CUERT-Shell/OpenPowerModuleBrainDead_V0SL/PowerModule/PowerModule.kicad_pcb

## KiCad design PowerModule/PowerModule.kicad_pcb (2025-09-24)

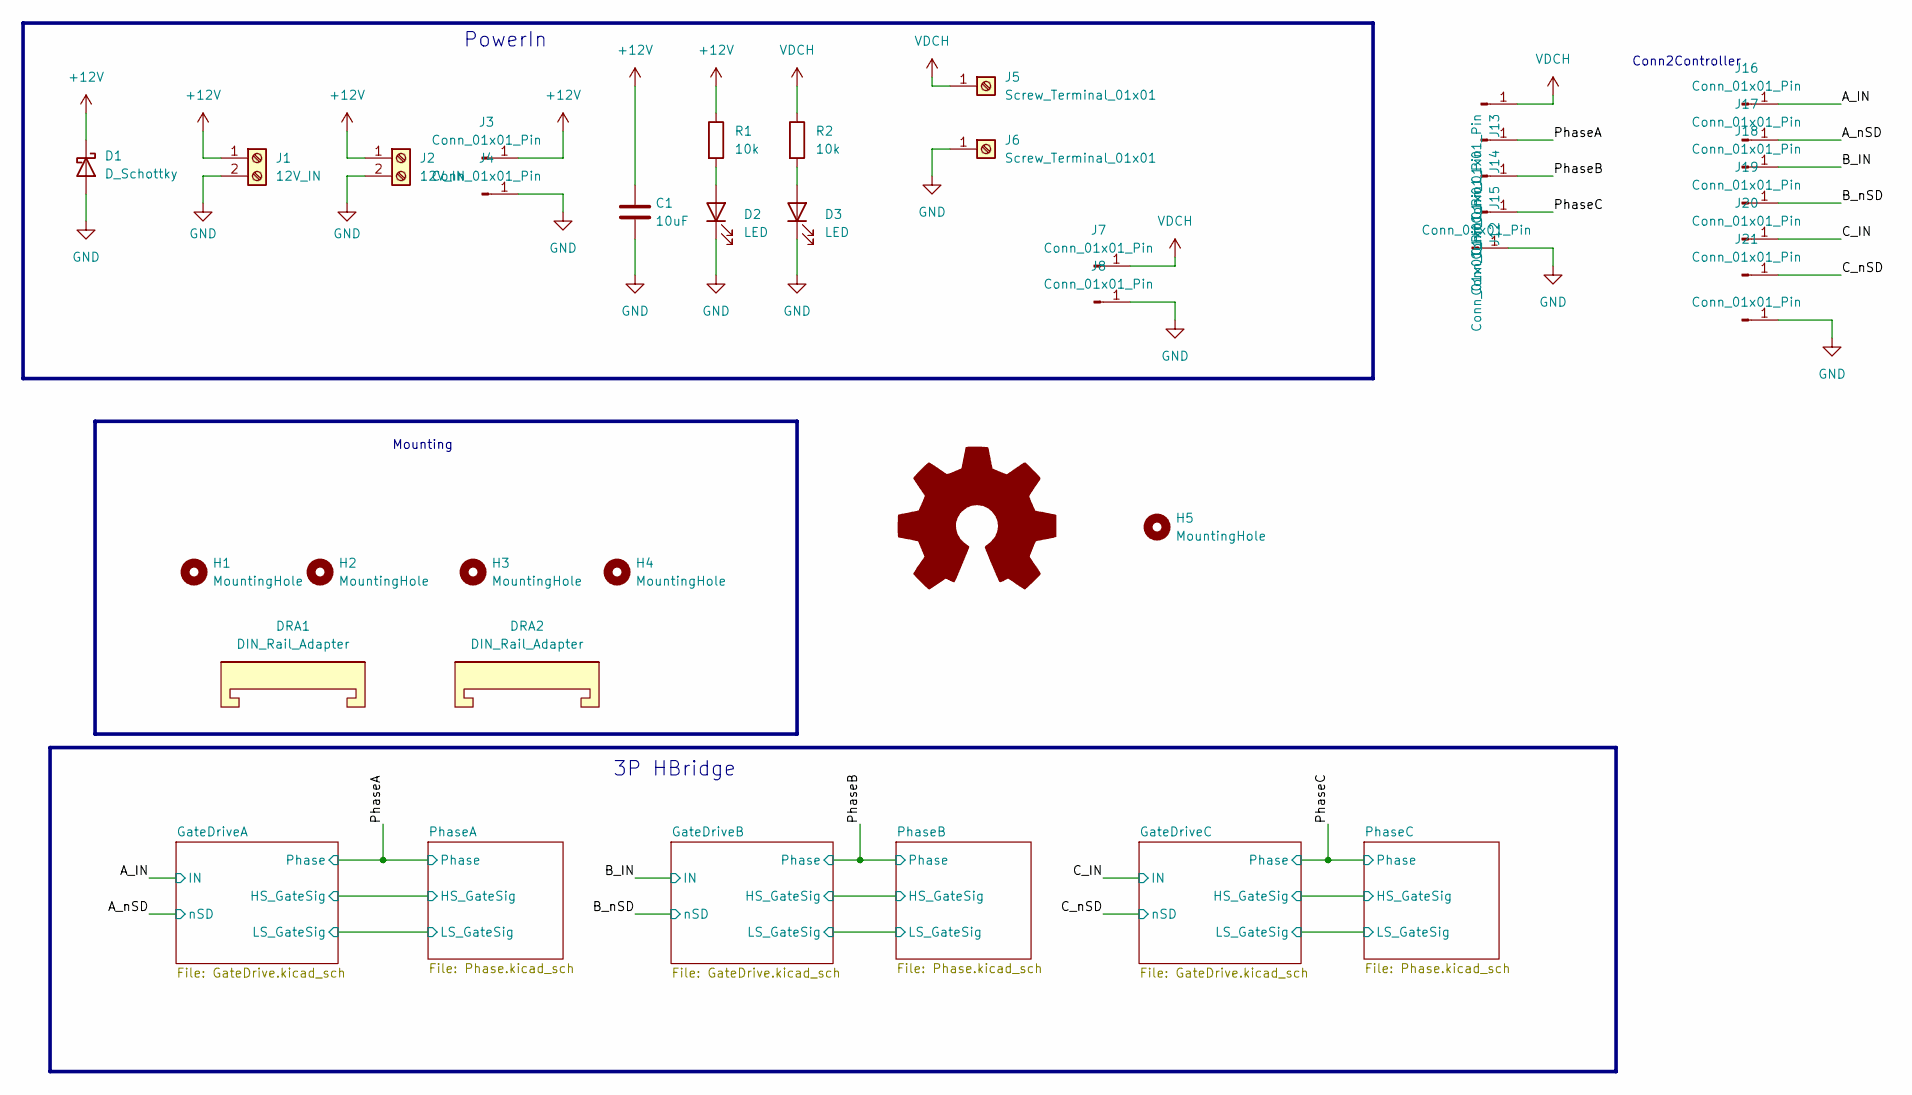
[picture p5: schematic PowerModule.kicad_sch]

Parts:
C1: 10uF; C_1206_3216Metric
D1: D_Schottky; D_SMC-RM10_Universal_Handsoldering
D2, D3: LED; LED_1206_3216Metric_Pad1.42x1.75mm_HandSolder
DRA1, DRA2: DIN_Rail_Adapter; DinRailPCBClip_P15
H1, H2, H3, H4: MountingHole; MountingHole_3.2mm_M3_DIN965
H5: MountingHole; KiCad-Logo2_12mm_SilkScreen
J1, J2: 12V_IN; TerminalBlock_Phoenix_PT-1,5-2-3.5-H_1x02_P3.50mm_Horizontal
J3, J4, J7, J8, J11, J12, J13, J14, J15, J16, J17, J18, J19, J20, J21, J22: Conn_01x01_Pin; WirePad_2.5x5
J5, J6: Screw_Terminal_01x01; D5mm_WirePad
R1, R2: 10k; R_1206_3216Metric_Pad1.30x1.75mm_HandSolder

Connections:
+12V: C1.1, D1.1 (K), J1.1, J2.1, J3.1, R1.1; also elsewhere on the board
/A_IN: J16.1; also elsewhere on the board
/A_nSD: J17.1; also elsewhere on the board
/B_IN: J18.1; also elsewhere on the board
/B_nSD: J19.1; also elsewhere on the board
/C_IN: J20.1; also elsewhere on the board
/C_nSD: J21.1; also elsewhere on the board
/PhaseA: J14.1; also elsewhere on the board
/PhaseB: J15.1; also elsewhere on the board
/PhaseC: J12.1; also elsewhere on the board
GND: C1.2, D1.2 (A), D2.1 (K), D3.1 (K), J1.2, J2.2, J4.1, J6.1, J8.1, J11.1, J22.1; also elsewhere on the board
unnamed: D2.2 (A), R1.2
unnamed: D3.2 (A), R2.2
VDCH: J5.1, J7.1, J13.1, R2.1; also elsewhere on the board

Notes on the sheet:
Mounting
3P HBridge
Conn2Controller
PowerIn

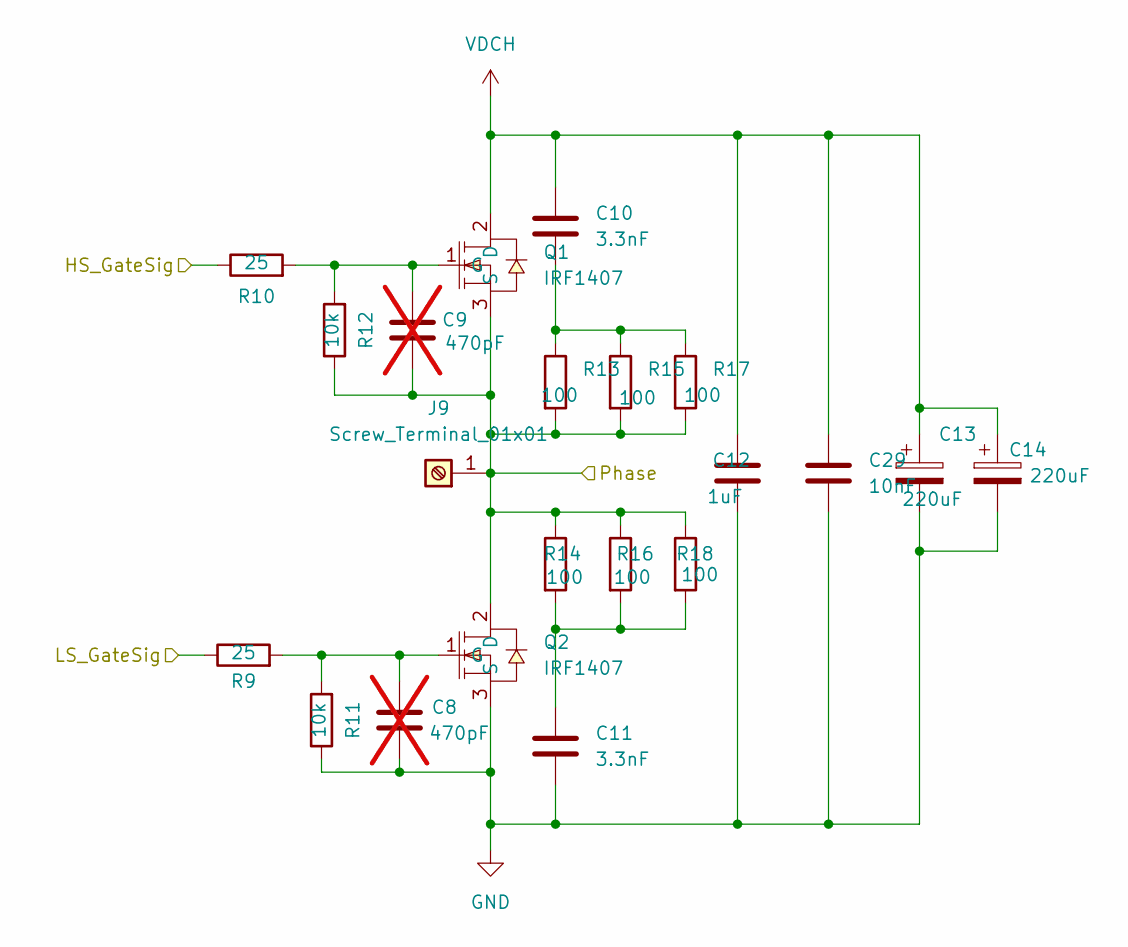
[picture p6: schematic Phase.kicad_sch]

Parts:
C8, C9: 470pF; C_1206_3216Metric; not fitted
C10, C11: 3.3nF; C_Rect_L7.2mm_W3.5mm_P5.00mm_FKS2_FKP2_MKS2_MKP2
C12: 1uF; C_Rect_L9.0mm_W5.1mm_P7.50mm_MKT
C13: 220uF; CP_Radial_Horizontal_P5.00_Up
C14: 220uF; CP_Radial_Horizontal_P5.00_Down
C29: 10nF; C_Rect_L7.2mm_W3.5mm_P5.00mm_FKS2_FKP2_MKS2_MKP2
J9: Screw_Terminal_01x01; D5mm_WirePad
Q1, Q2: IRF1407; TO-220-3_Horizontal_TabUp; LCSC Part C33129604
R9, R10: 25; R_1206_3216Metric
R11, R12: 10k; R_1206_3216Metric
R13, R14, R15, R16, R17, R18: 100; R_1206_3216Metric

Connections:
/GateDriveA/HS_GateSig: R10.1; also elsewhere on the board
/GateDriveA/LS_GateSig: R9.1; also elsewhere on the board
/PhaseA: C9.2, J9.1, Q1.3 (S), Q2.2 (D), R12.1, R13.2, R14.1, R15.2, R16.1, R17.2, R18.1; also elsewhere on the board
GND: C8.2, C11.2, C12.2, C13.2, C14.2, C29.2, Q2.3 (S), R11.1; also elsewhere on the board
unnamed: C10.2, R13.1, R15.1, R17.1
unnamed: C11.1, R14.2, R16.2, R18.2
unnamed: C9.1, Q1.1 (G), R10.2, R12.2
unnamed: C8.1, Q2.1 (G), R9.2, R11.2
VDCH: C10.1, C12.1, C13.1, C14.1, C29.1, Q1.2 (D); also elsewhere on the board

Parts of its further copies:
C15, C16, C22, C23: 470pF; C_1206_3216Metric; not fitted
C17, C18, C24, C25: 3.3nF; C_Rect_L7.2mm_W3.5mm_P5.00mm_FKS2_FKP2_MKS2_MKP2
C19, C26: 1uF; C_Rect_L9.0mm_W5.1mm_P7.50mm_MKT
C20, C27: 220uF; CP_Radial_Horizontal_P5.00_Up
C21, C28: 220uF; CP_Radial_Horizontal_P5.00_Down
C30, C31: 10nF; C_Rect_L7.2mm_W3.5mm_P5.00mm_FKS2_FKP2_MKS2_MKP2
J10, J23: Screw_Terminal_01x01; D5mm_WirePad
Q3, Q4, Q5, Q6: IRF1407; TO-220-3_Horizontal_TabUp; LCSC Part C33129604
R19, R20, R29, R30: 25; R_1206_3216Metric
R21, R22, R31, R32: 10k; R_1206_3216Metric
R23, R24, R25, R26, R27, R28, R33, R34, R35, R36, R37, R38: 100; R_1206_3216Metric

Connections of its further copies:
/GateDriveB/HS_GateSig: R20.1; also elsewhere on the board
/GateDriveB/LS_GateSig: R19.1; also elsewhere on the board
/GateDriveC/HS_GateSig: R30.1; also elsewhere on the board
/GateDriveC/LS_GateSig: R29.1; also elsewhere on the board
/PhaseB: C16.2, J10.1, Q3.3 (S), Q4.2 (D), R22.1, R23.2, R24.1, R25.2, R26.1, R27.2, R28.1; also elsewhere on the board
/PhaseC: C23.2, J23.1, Q5.3 (S), Q6.2 (D), R32.1, R33.2, R34.1, R35.2, R36.1, R37.2, R38.1; also elsewhere on the board
GND: C15.2, C18.2, C19.2, C20.2, C21.2, C22.2, C25.2, C26.2, C27.2, C28.2, C30.2, C31.2, Q4.3 (S), Q6.3 (S), R21.1, R31.1; also elsewhere on the board
unnamed: C17.2, R23.1, R25.1, R27.1
unnamed: C18.1, R24.2, R26.2, R28.2
unnamed: C24.2, R33.1, R35.1, R37.1
unnamed: C25.1, R34.2, R36.2, R38.2
unnamed: C16.1, Q3.1 (G), R20.2, R22.2
unnamed: C15.1, Q4.1 (G), R19.2, R21.2
unnamed: C23.1, Q5.1 (G), R30.2, R32.2
unnamed: C22.1, Q6.1 (G), R29.2, R31.2
VDCH: C17.1, C19.1, C20.1, C21.1, C24.1, C26.1, C27.1, C28.1, C30.1, C31.1, Q3.2 (D), Q5.2 (D); also elsewhere on the board

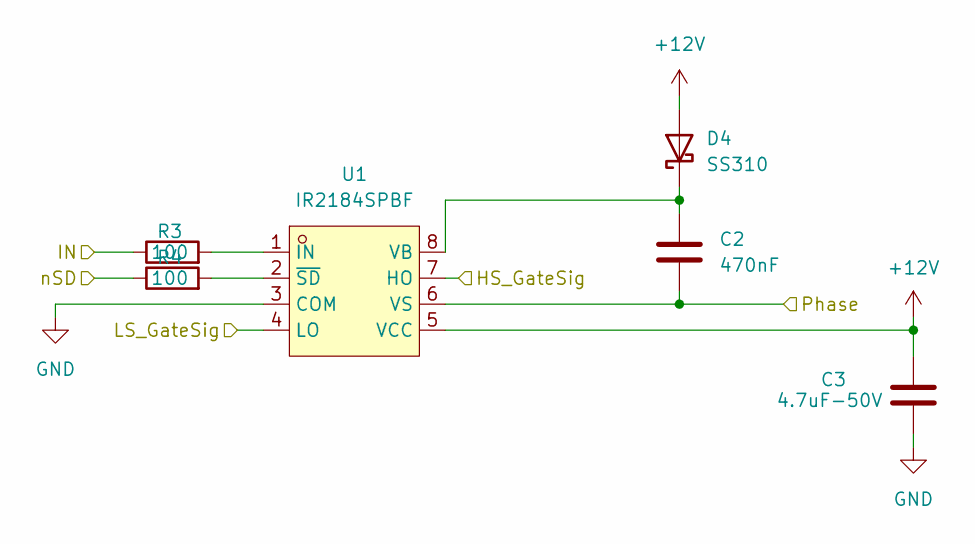
[picture p7: schematic GateDrive.kicad_sch]

Parts:
C2: 470nF; C_Rect_L9.0mm_W5.1mm_P7.50mm_MKT
C3: 4.7uF-50V; C_1206_3216Metric
D4: SS310; D_SMC-RM10_Universal_Handsoldering
R3, R4: 100; R_1206_3216Metric
U1: IR2184SPBF; SOIC-8_L5.0-W4.0-P1.27-LS6.0-BL; LCSC Part C537610

Connections:
+12V: C3.1, D4.2 (A), U1.5 (VCC); also elsewhere on the board
/A_IN: R3.1; also elsewhere on the board
/A_nSD: R4.1; also elsewhere on the board
/GateDriveA/HS_GateSig: U1.7 (HO); also elsewhere on the board
/GateDriveA/LS_GateSig: U1.4 (LO); also elsewhere on the board
/PhaseA: C2.2, U1.6 (VS); also elsewhere on the board
GND: C3.2, U1.3 (COM); also elsewhere on the board
unnamed: C2.1, D4.1 (K), U1.8 (VB)
unnamed: R3.2, U1.1 (IN)
unnamed: R4.2, U1.2 (~SD)

Parts of its further copies:
C4, C6: 470nF; C_Rect_L9.0mm_W5.1mm_P7.50mm_MKT
C5, C7: 4.7uF-50V; C_1206_3216Metric
D5, D6: SS310; D_SMC-RM10_Universal_Handsoldering
R5, R6, R7, R8: 100; R_1206_3216Metric
U2, U3: IR2184SPBF; SOIC-8_L5.0-W4.0-P1.27-LS6.0-BL; LCSC Part C537610

Connections of its further copies:
+12V: C5.1, C7.1, D5.2 (A), D6.2 (A), U2.5 (VCC), U3.5 (VCC); also elsewhere on the board
/B_IN: R5.1; also elsewhere on the board
/B_nSD: R6.1; also elsewhere on the board
/C_IN: R7.1; also elsewhere on the board
/C_nSD: R8.1; also elsewhere on the board
/GateDriveB/HS_GateSig: U2.7 (HO); also elsewhere on the board
/GateDriveB/LS_GateSig: U2.4 (LO); also elsewhere on the board
/GateDriveC/HS_GateSig: U3.7 (HO); also elsewhere on the board
/GateDriveC/LS_GateSig: U3.4 (LO); also elsewhere on the board
/PhaseB: C4.2, U2.6 (VS); also elsewhere on the board
/PhaseC: C6.2, U3.6 (VS); also elsewhere on the board
GND: C5.2, C7.2, U2.3 (COM), U3.3 (COM); also elsewhere on the board
unnamed: C4.1, D5.1 (K), U2.8 (VB)
unnamed: C6.1, D6.1 (K), U3.8 (VB)
unnamed: R5.2, U2.1 (IN)
unnamed: R6.2, U2.2 (~SD)
unnamed: R7.2, U3.1 (IN)
unnamed: R8.2, U3.2 (~SD)

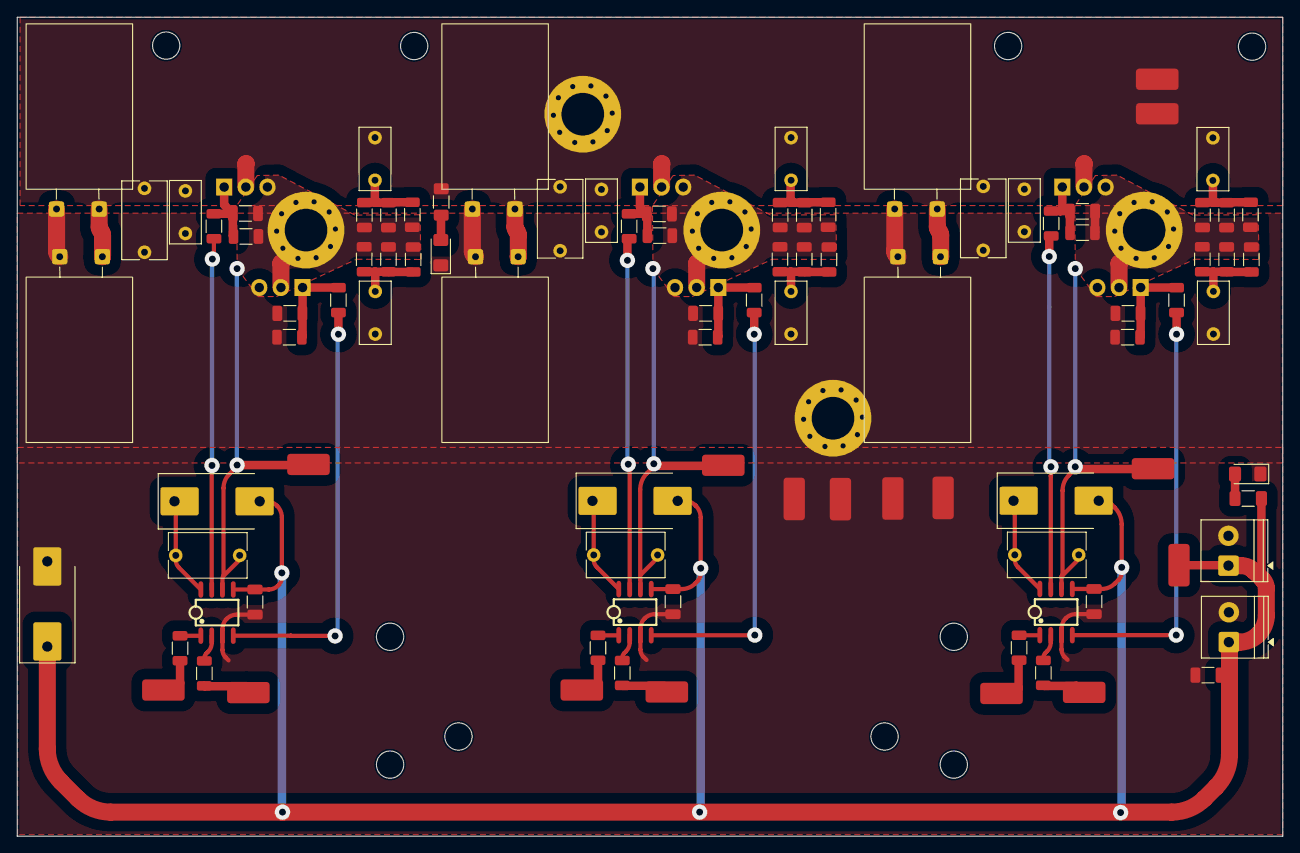
[picture p8: board PowerModule.kicad_pcb from above]

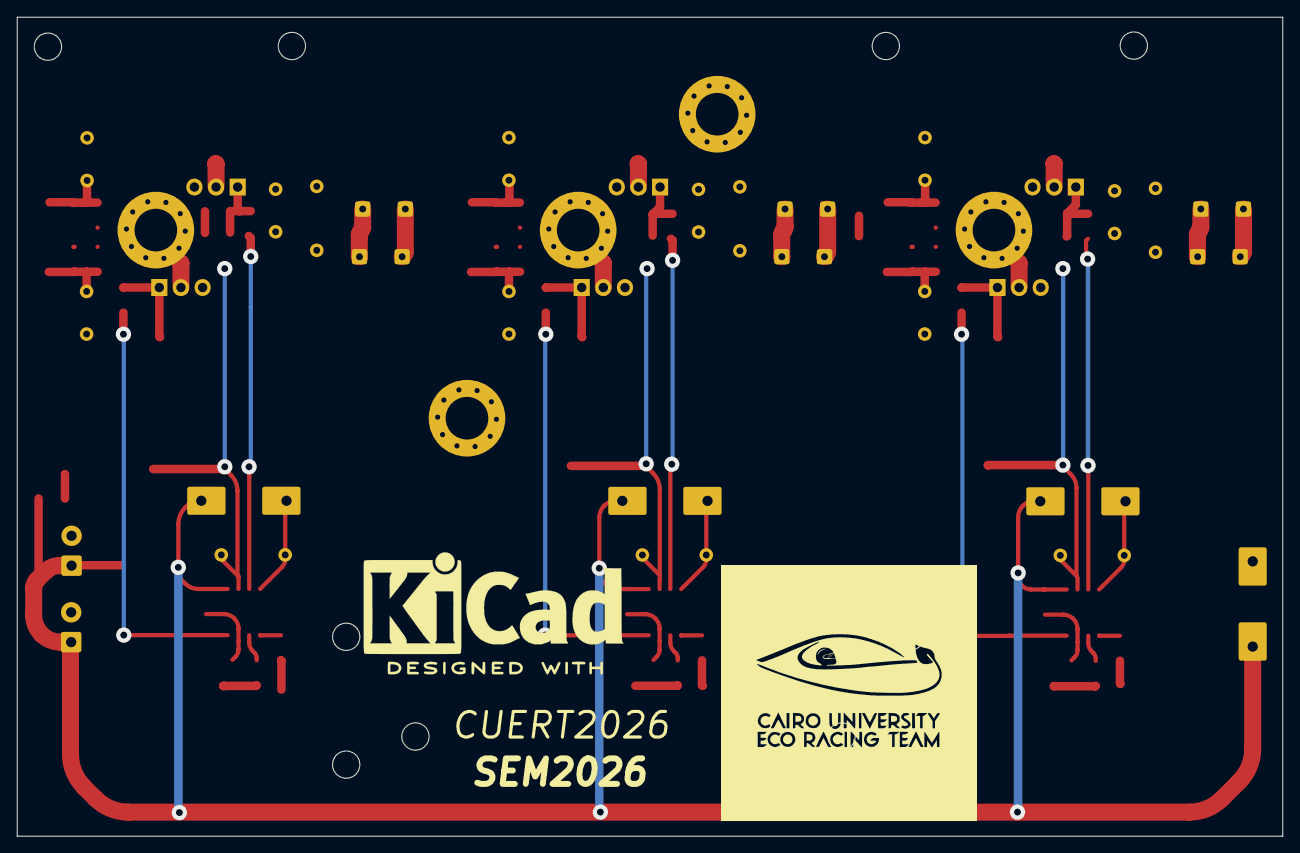
[picture p9: board PowerModule.kicad_pcb from below]

Board: 2 copper layers, 148.5 x 96.1 mm, 114 parts (7 on the bottom side), 41 nets.
