CUERT-Shell/OpenPowerModuleBrainDead_V0SL/PowerModuleInterface/PowerModuleInterface.kicad_pcb

## KiCad design PowerModuleInterface/PowerModuleInterface.kicad_pcb (2025-09-24)

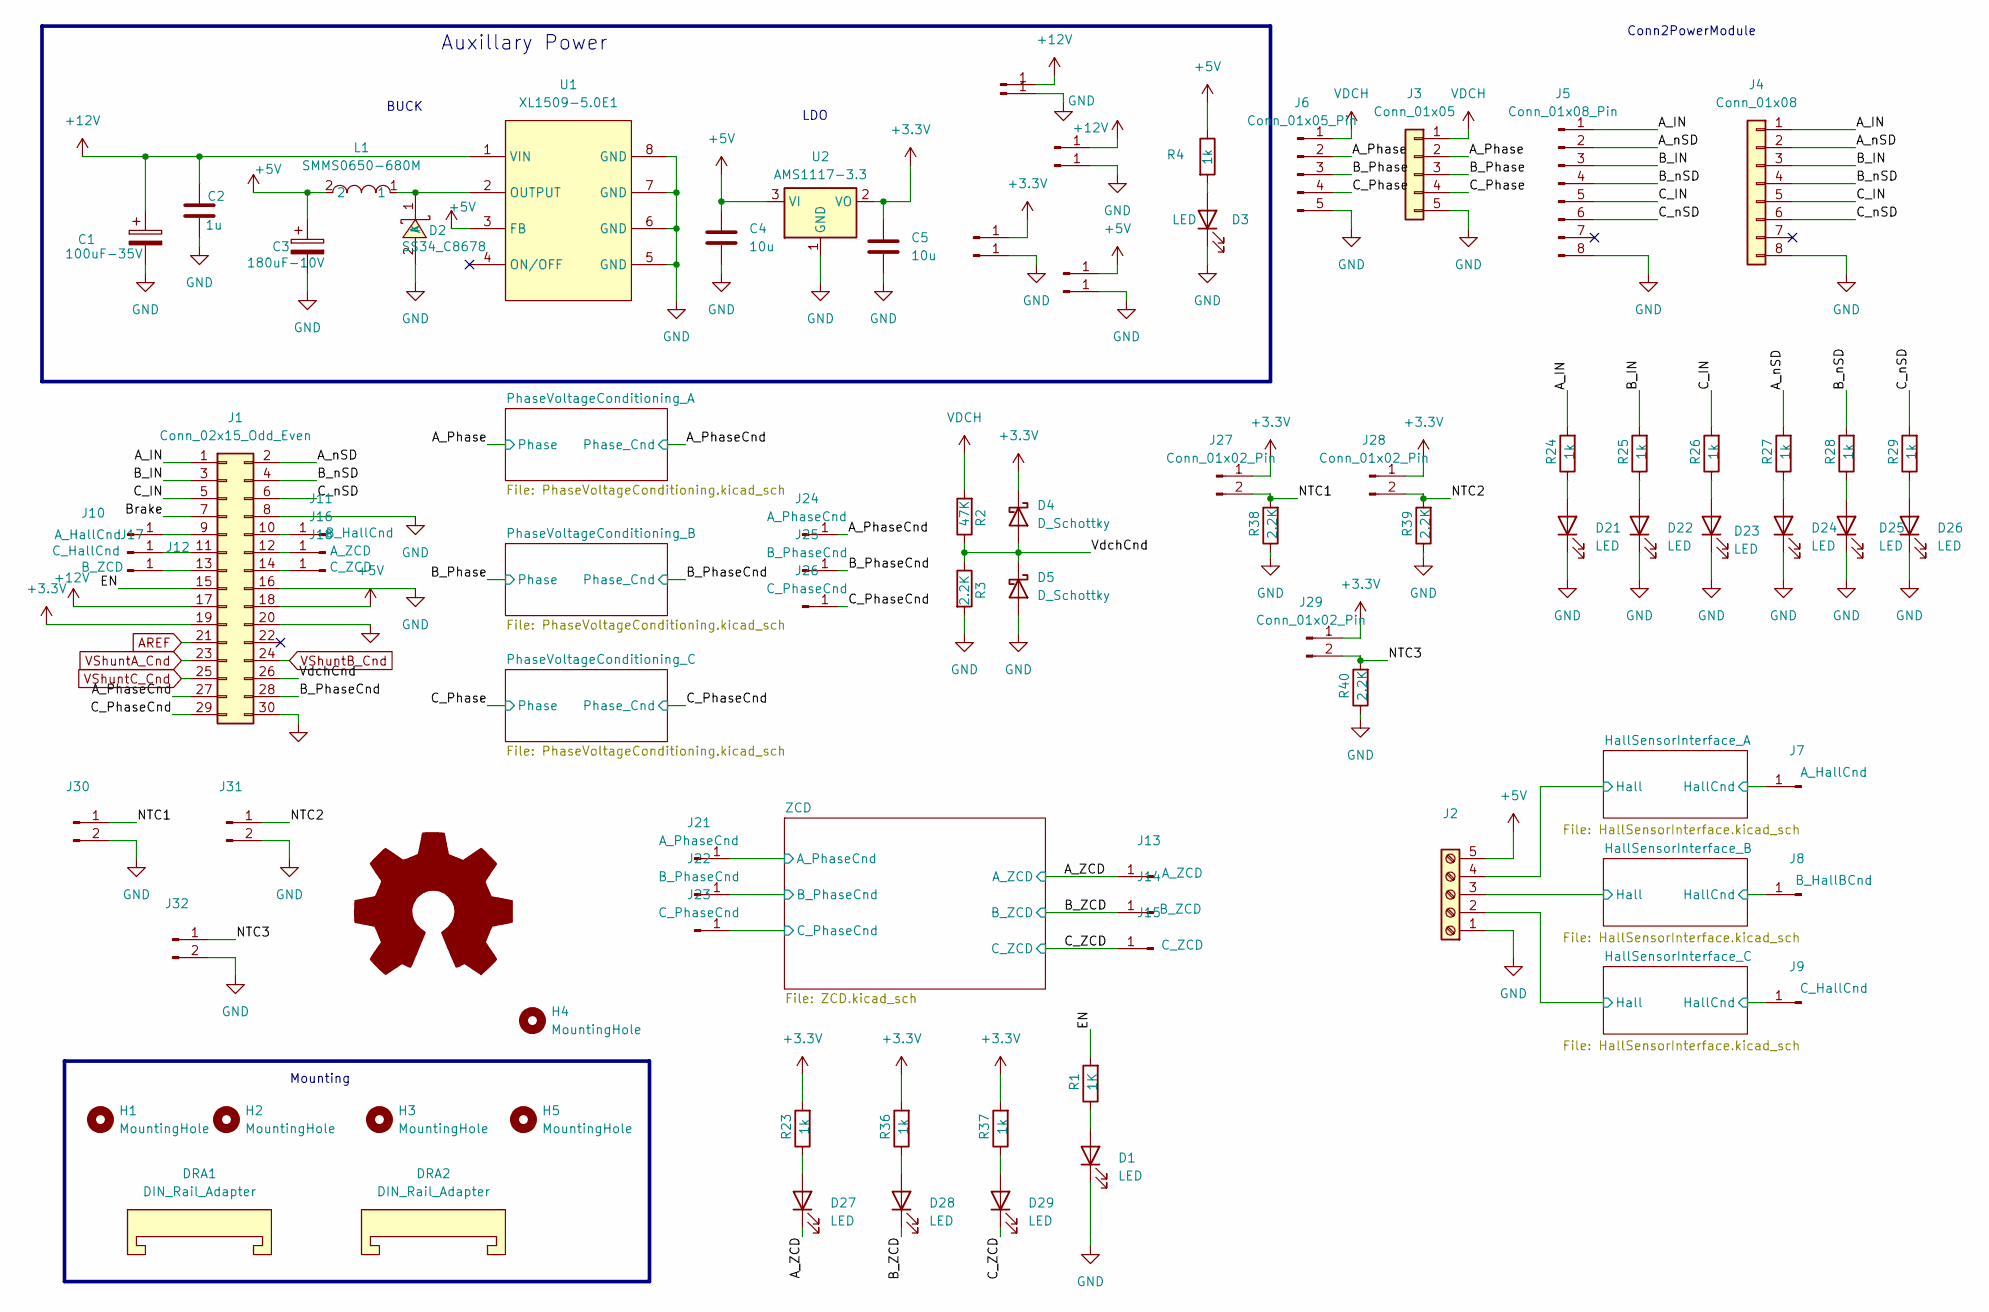
[picture p10: schematic PowerModuleInterface.kicad_sch]

Parts:
C1: 100uF-35V; CP_Radial_D6.3mm_P2.50mm
C2: 1u; C_1206_3216Metric
C3: 180uF-10V; CP_Radial_D6.3mm_P2.50mm
C4, C5: 10u; C_1206_3216Metric
D1, D3, D21, D22, D23, D24, D25, D26, D27, D28, D29: LED; LED_D3.0mm
D2: SS34_C8678; SMA_L4.3-W2.6-LS5.2-RD; LCSC Part C8678
D4, D5: D_Schottky; D_SOD-123; LCSC Part C181204
DRA1, DRA2: DIN_Rail_Adapter; DinRailPCBClip_P15
H1, H2, H3, H5: MountingHole; MountingHole_3.2mm_M3_DIN965
H4: MountingHole; KiCad-Logo2_6mm_SilkScreen
J1: Conn_02x15_Odd_Even; IDC-Header_2x15_P2.54mm_Vertical
J2: Screw_Terminal_01x05; TerminalBlock_Phoenix_PT-1,5-5-3.5-H_1x05_P3.50mm_Horizontal
J3: Conn_01x05; JST_XH_B5B-XH-A_1x05_P2.50mm_Vertical
J4: Conn_01x08; JST_XH_B8B-XH-A_1x08_P2.50mm_Vertical
J5: Conn_01x08_Pin; PinHeader_1x08_P2.54mm_Vertical
J6: Conn_01x05_Pin; PinHeader_1x05_P2.54mm_Vertical
J7, J10: A_HallCnd; WirePad_2.5x5
J8: B_HallBCnd; WirePad_2.5x5
J9, J12: C_HallCnd; WirePad_2.5x5
J11: B_HallCnd; WirePad_2.5x5
J13, J16: A_ZCD; WirePad_2.5x5
J14, J17: B_ZCD; WirePad_2.5x5
J15, J18: C_ZCD; WirePad_2.5x5
J19, J20, J33, J34, J35, J36, J37, J38: Conn_01x01_Pin; WirePad_2.5x5
J21, J24: A_PhaseCnd; WirePad_2.5x5
J22, J25: B_PhaseCnd; WirePad_2.5x5
J23, J26: C_PhaseCnd; WirePad_2.5x5
J27, J28, J29, J30, J31, J32: Conn_01x02_Pin; PinHeader_1x02_P2.54mm_Vertical
L1: SMMS0650-680M; IND-SMD_L7.1-W6.6_H5.0; LCSC Part C2894721
R1: 1K; R_1206_3216Metric; LCSC Part C113307
R2: 47K; R_1206_3216Metric
R3: 2.2K; R_1206_3216Metric
R4: 1k; R_1206_3216Metric
R23, R24, R25, R26, R27, R28, R29, R36, R37: 1k; R_1206_3216Metric; LCSC Part C113307
R38, R39, R40: 2.2K; R_1206_3216Metric; LCSC Part C113307
U1: XL1509-5.0E1; SOIC-8_L5.0-W4.0-P1.27-LS6.0-BL; LCSC Part C61063
U2: AMS1117-3.3; SOT-223-3_TabPin2

Connections:
+3.3V: C5.1, D4.1 (K), J1.19, J27.1, J28.1, J29.1, J37.1, R23.2, R36.2, R37.2, U2.2 (VO); also elsewhere on the board
+5V: C3.1, C4.1, J1.18, J2.5, J33.1, L1.2, R4.1, U1.3 (FB), U2.3 (VI)
+12V: C1.1, C2.1, J1.17, J19.1, J35.1, U1.1 (VIN); also elsewhere on the board
/A_IN: J1.1, J4.1, J5.1, R24.2
/A_Phase: J3.2, J6.2; also elsewhere on the board
/A_PhaseCnd: J1.27, J24.1; also elsewhere on the board
/A_ZCD: D27.1 (K), J13.1; also elsewhere on the board
/A_nSD: J1.2, J4.2, J5.2, R27.2
/B_IN: J1.3, J4.3, J5.3, R25.2
/B_Phase: J3.3, J6.3; also elsewhere on the board
/B_PhaseCnd: J1.28, J25.1; also elsewhere on the board
/B_ZCD: D28.1 (K), J14.1; also elsewhere on the board
/B_nSD: J1.4, J4.4, J5.4, R28.2
/Brake: J1.7
/C_IN: J1.5, J4.5, J5.5, R26.2
/C_Phase: J3.4, J6.4; also elsewhere on the board
/C_PhaseCnd: J1.29, J26.1; also elsewhere on the board
/C_ZCD: D29.1 (K), J15.1; also elsewhere on the board
/C_nSD: J1.6, J4.6, J5.6, R29.2
/EN: J1.15, R1.2
/HallSensorInterface_A/Hall: J2.4; also elsewhere on the board
/HallSensorInterface_A/HallCnd: J7.1; also elsewhere on the board
/HallSensorInterface_B/Hall: J2.3; also elsewhere on the board
/HallSensorInterface_B/HallCnd: J8.1; also elsewhere on the board
/HallSensorInterface_C/Hall: J2.2; also elsewhere on the board
/HallSensorInterface_C/HallCnd: J9.1; also elsewhere on the board
/NTC1: J27.2, J30.1, R38.2
/NTC2: J28.2, J31.1, R39.2
/NTC3: J29.2, J32.1, R40.2
/VdchCnd: D4.2 (A), D5.1 (K), J1.26, R2.1, R3.1
/ZCD/A_PhaseCnd: J21.1; also elsewhere on the board
/ZCD/B_PhaseCnd: J22.1; also elsewhere on the board
/ZCD/C_PhaseCnd: J23.1; also elsewhere on the board
AREF: J1.21
GND: C1.2, C2.2, C3.2, C4.2, C5.2, D1.1 (K), D2.2 (A), D3.1 (K), D5.2 (A), D21.1 (K), D22.1 (K), D23.1 (K), D24.1 (K), D25.1 (K), D26.1 (K), J1.8, J1.16, J1.20, J1.30, J2.1, J3.5, J4.8, J5.8, J6.5, J20.1, J30.2, J31.2, J32.2, J34.1, J36.1, J38.1, R3.2, R38.1, R39.1, R40.1, U1.5 (GND), U1.6 (GND), U1.7 (GND), U1.8 (GND), U2.1 (GND); also elsewhere on the board
unnamed: D1.2 (A), R1.1
unnamed: D2.1 (K), L1.1, U1.2 (OUTPUT)
unnamed: D3.2 (A), R4.2
unnamed: D21.2 (A), R24.1
unnamed: D22.2 (A), R25.1
unnamed: D23.2 (A), R26.1
unnamed: D24.2 (A), R27.1
unnamed: D25.2 (A), R28.1
unnamed: D26.2 (A), R29.1
unnamed: D27.2 (A), R23.1
unnamed: D28.2 (A), R36.1
unnamed: D29.2 (A), R37.1
unnamed: J1.9, J10.1
unnamed: J1.10, J11.1
unnamed: J1.11, J12.1
unnamed: J1.12, J16.1
unnamed: J1.13, J17.1
unnamed: J1.14, J18.1
VDCH: J3.1, J6.1, R2.2
VShuntA_Cnd: J1.23
VShuntB_Cnd: J1.24
VShuntC_Cnd: J1.25

Notes on the sheet:
Conn2PowerModule
Mounting
BUCK
LDO
Auxillary Power

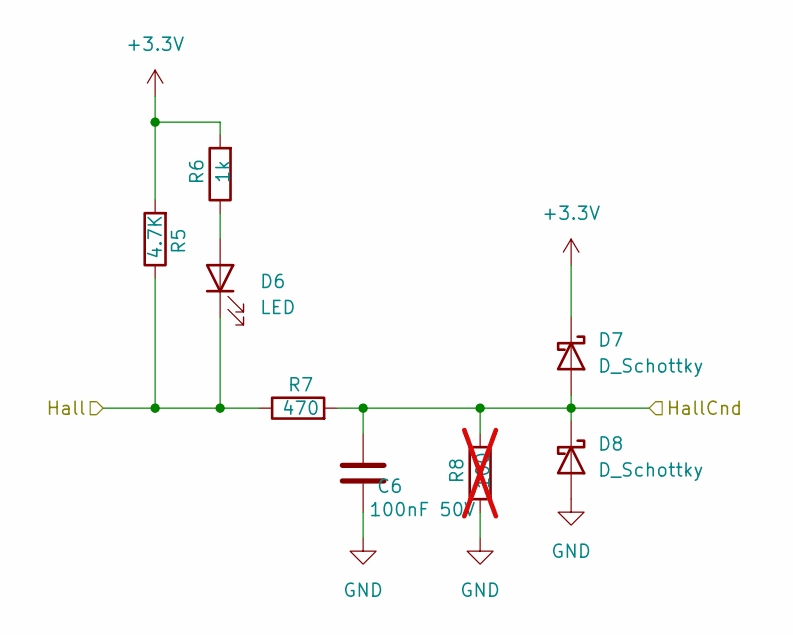
[picture p11: schematic HallSensorInterface.kicad_sch]

Parts:
C6: 100nF 50V; C_1206_3216Metric; LCSC Part C24497
D6: LED; LED_D3.0mm
D7, D8: D_Schottky; D_SOD-123; LCSC Part C181204
R5: 4.7K; R_1206_3216Metric; LCSC Part C17902
R6: 1k; R_1206_3216Metric; LCSC Part C113307
R7: 470; R_1206_3216Metric; LCSC Part C113307
R8: 100; R_1206_3216Metric; LCSC Part C113307; not fitted

Connections:
+3.3V: D7.1 (K), R5.2, R6.2; also elsewhere on the board
/HallSensorInterface_B/Hall: D6.1 (K), R5.1, R7.1; also elsewhere on the board
/HallSensorInterface_B/HallCnd: C6.1, D7.2 (A), D8.1 (K), R7.2, R8.2; also elsewhere on the board
GND: C6.2, D8.2 (A), R8.1; also elsewhere on the board
unnamed: D6.2 (A), R6.1

Parts of its further copies:
C8, C9: 100nF 50V; C_1206_3216Metric; LCSC Part C24497
D11, D14: LED; LED_D3.0mm
D12, D13, D15, D16: D_Schottky; D_SOD-123; LCSC Part C181204
R11, R15: 4.7K; R_1206_3216Metric; LCSC Part C17902
R12, R16: 1k; R_1206_3216Metric; LCSC Part C113307
R13, R17: 470; R_1206_3216Metric; LCSC Part C113307
R14, R18: 100; R_1206_3216Metric; LCSC Part C113307; not fitted

Connections of its further copies:
+3.3V: D12.1 (K), D15.1 (K), R11.2, R12.2, R15.2, R16.2; also elsewhere on the board
/HallSensorInterface_A/Hall: D14.1 (K), R15.1, R17.1; also elsewhere on the board
/HallSensorInterface_A/HallCnd: C9.1, D15.2 (A), D16.1 (K), R17.2, R18.2; also elsewhere on the board
/HallSensorInterface_C/Hall: D11.1 (K), R11.1, R13.1; also elsewhere on the board
/HallSensorInterface_C/HallCnd: C8.1, D12.2 (A), D13.1 (K), R13.2, R14.2; also elsewhere on the board
GND: C8.2, C9.2, D13.2 (A), D16.2 (A), R14.1, R18.1; also elsewhere on the board
unnamed: D11.2 (A), R12.1
unnamed: D14.2 (A), R16.1

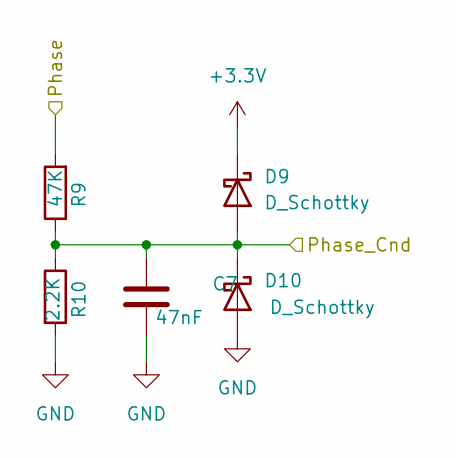
[picture p12: schematic PhaseVoltageConditioning.kicad_sch]

Parts:
C7: 47nF; C_1206_3216Metric
D9, D10: D_Schottky; D_SOD-123; LCSC Part C181204
R9: 47K; R_1206_3216Metric
R10: 2.2K; R_1206_3216Metric

Connections:
+3.3V: D9.1 (K); also elsewhere on the board
/A_Phase: R9.2; also elsewhere on the board
/A_PhaseCnd: C7.1, D9.2 (A), D10.1 (K), R9.1, R10.1; also elsewhere on the board
GND: C7.2, D10.2 (A), R10.2; also elsewhere on the board

Parts of its further copies:
C10, C11: 47nF; C_1206_3216Metric
D17, D18, D19, D20: D_Schottky; D_SOD-123; LCSC Part C181204
R19, R21: 47K; R_1206_3216Metric
R20, R22: 2.2K; R_1206_3216Metric

Connections of its further copies:
+3.3V: D17.1 (K), D19.1 (K); also elsewhere on the board
/B_Phase: R21.2; also elsewhere on the board
/B_PhaseCnd: C11.1, D19.2 (A), D20.1 (K), R21.1, R22.1; also elsewhere on the board
/C_Phase: R19.2; also elsewhere on the board
/C_PhaseCnd: C10.1, D17.2 (A), D18.1 (K), R19.1, R20.1; also elsewhere on the board
GND: C10.2, C11.2, D18.2 (A), D20.2 (A), R20.2, R22.2; also elsewhere on the board

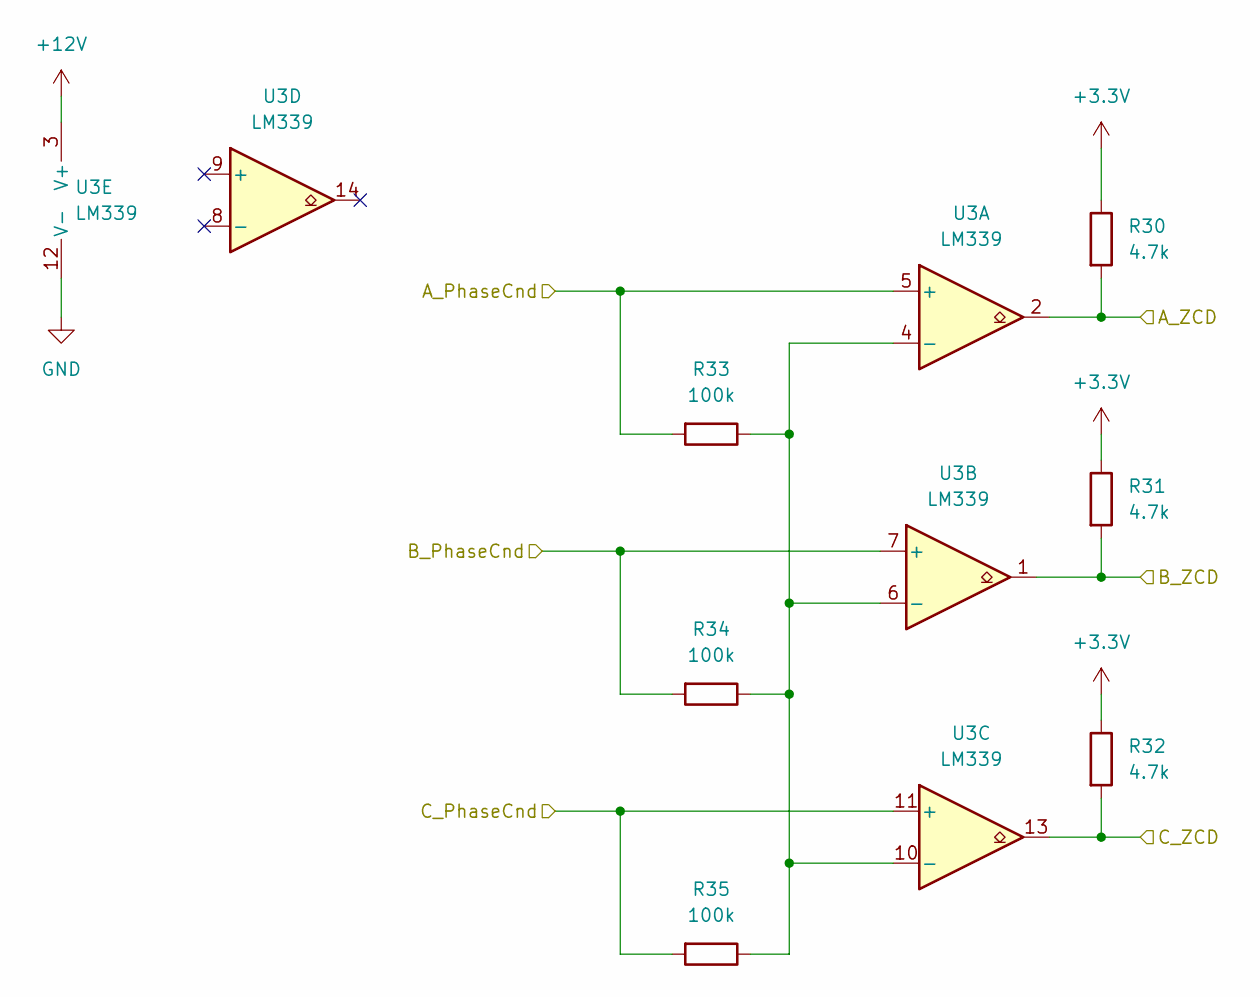
[picture p13: schematic ZCD.kicad_sch]

Parts:
R30, R31, R32: 4.7k; R_1206_3216Metric
R33, R34, R35: 100k; R_1206_3216Metric
U3: LM339; SOIC-14_3.9x8.7mm_P1.27mm

Connections:
+3.3V: R30.1, R31.1, R32.1; also elsewhere on the board
+12V: U3.3 (V+); also elsewhere on the board
/A_ZCD: R30.2, U3.2; also elsewhere on the board
/B_ZCD: R31.2, U3.1; also elsewhere on the board
/C_ZCD: R32.2, U3.13; also elsewhere on the board
/ZCD/A_PhaseCnd: R33.2, U3.5 (+); also elsewhere on the board
/ZCD/B_PhaseCnd: R34.2, U3.7 (+); also elsewhere on the board
/ZCD/C_PhaseCnd: R35.2, U3.11 (+); also elsewhere on the board
GND: U3.12 (V-); also elsewhere on the board
unnamed: R33.1, R34.1, R35.1, U3.4 (-), U3.6 (-), U3.10 (-)

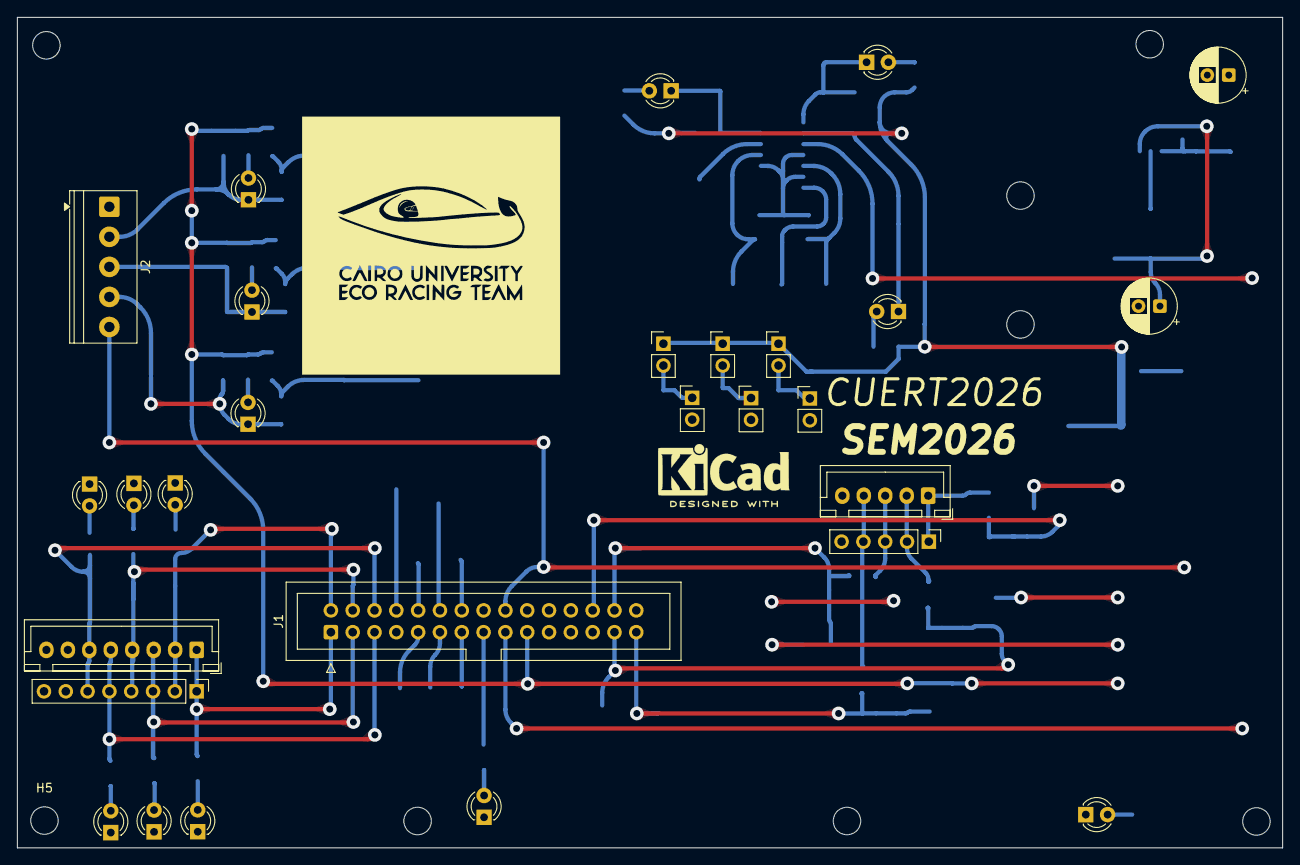
[picture p14: board PowerModuleInterface.kicad_pcb from above]

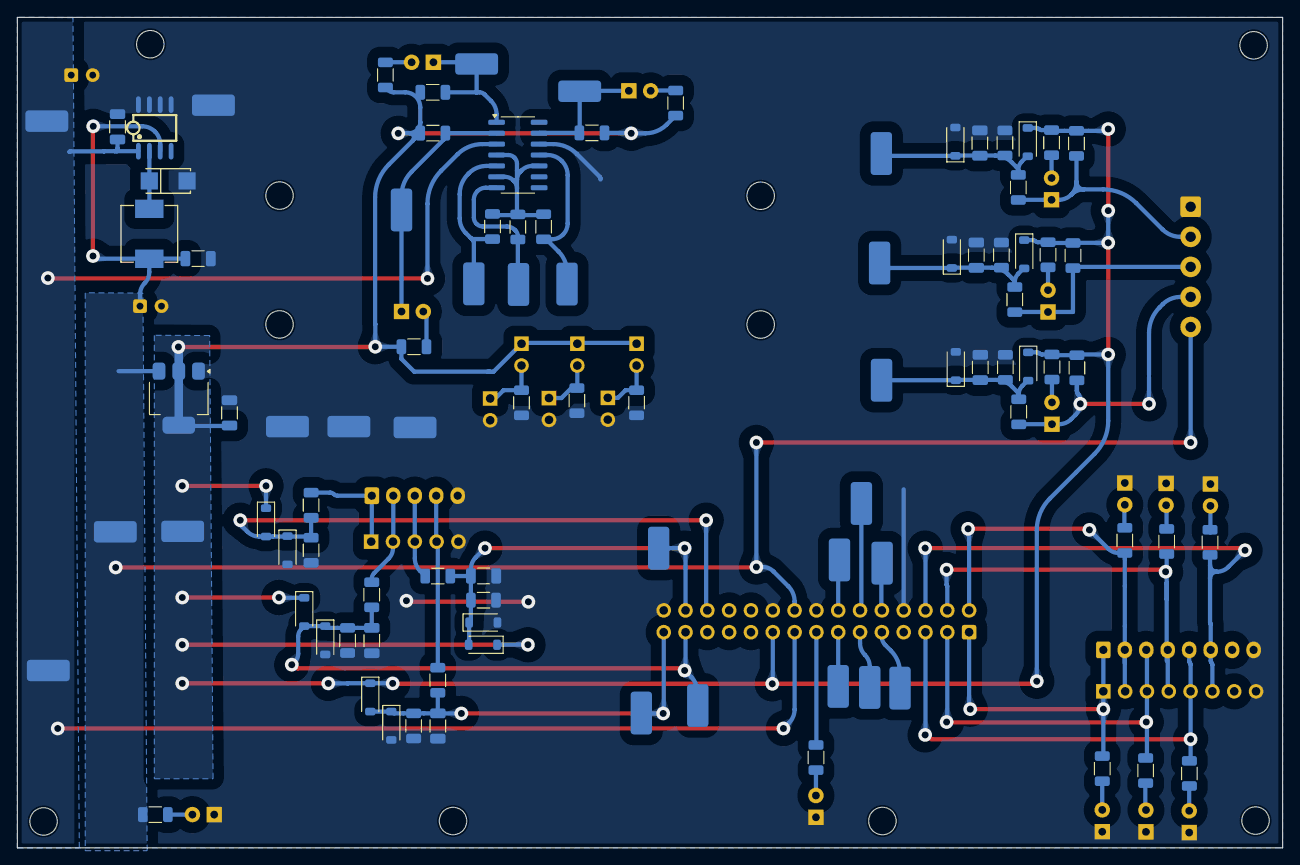
[picture p15: board PowerModuleInterface.kicad_pcb from below]

Board: 2 copper layers, 147.3 x 96.7 mm, 129 parts (94 on the bottom side), 56 nets.
